kiluhabe/Radio/ROADMAP.md

# 🗺️ Roadmap

- PCB 化
- OLED大型化
- ディスプレイアニメーション
- テープライクな録音・再生（下記「録音・再生機能」参照）
- スピーカー内蔵＋ジャック挿入時の自動切替（下記参照）

## スピーカー内蔵＋ジャック自動切替

小型スピーカーを内蔵し、ジャックにプラグが挿入されたらジャック出力へ切り替える構成。

### 必要な追加部品

| 部品 | 型番・仕様 | 備考 |
|---|---|---|
| マイクロスピーカー | 8Ω、23×16×4.6mm（[秋月 g112495](https://akizukidenshi.com/catalog/g/g112495/)） | 定格入力がページに未記載。0.5〜1W程度と推定 |
| モノラルアンプ | PAM8302A（2.5W BTL） | スピーカーが1個なのでステレオのPAM8403より素直 |
| スイッチ付きステレオジャック | MJ-352W-C（[秋月 g117359](https://akizukidenshi.com/catalog/g/g117359/)） | **現行のMJ-355Wはスイッチ接点なしのため交換が必要** |
| 抵抗 | 10kΩ×2 | L/Rをモノラル合成する用 |

### 信号経路

```
M5807PA LOUT/ROUT
  → 音量ポット（10kΩ Aカーブ2連）
      ├→ MJ-352W-C（ライン出力、アクティブスピーカー用）
      └→ 抵抗でL+Rをモノラル合成 → PAM8302A → 内蔵8Ωスピーカー
                                        ↑
                          SHUTDOWNピン ← ジャックのスイッチ接点
```

ポットの後段から分岐するので、物理ボリュームが内蔵スピーカーにも効く。切替はジャックの接点でアンプのSHUTDOWNピンを叩く形にすれば**ファームウェア変更は不要**（純ハードウェアで完結）。

### 注意点

- **スピーカーの定格入力が不明**。PAM8302Aをデフォルトゲイン（24dB）で使うと過大入力で破損の可能性がある。ゲイン設定抵抗を絞るか、実測しながら調整すること
- 23×16mmの小型なので低音はほぼ出ない。**密閉されたエンクロージャを筐体側に作り込むのが最も効く対策**（裸のユニットは前後の音が打ち消し合って低域が消える）。録音機能でADC→DSP→DACの経路を通すなら、倍音合成型のバスエンハンスをエフェクトの一つとして入れる手もある
- ポット出力にアンプ入力を並列でぶら下げるので負荷が変わる。10kΩポットとPAM8302Aの入力インピーダンスなら問題ない範囲のはずだが、実装後に音量カーブを確認すること

## 録音・再生機能（テープライク、検討メモ）

対象は**「2h順次上書きバッファ」「エンコーダーでのプレイバックサーチ」「再生速度変更」「エフェクト」の4つ**。

### 設計の要：全部バッファ経由にする

現状はFM音声がRP2040-Zeroを一切通らずポットへ直行しているが、これを「常にADC→RP2040-Zero→DAC」に変え、録音バッファへ常時書き込み続ける構成にする。すると「ライブ再生」は単に「読み出し位置＝書き込み位置」という特殊ケースになり、サーチ・可変速・エフェクトが全て同じ経路で処理できる。アナログの分岐・切替回路が不要になる。

### 容量と帯域の見積もり

| 形式 | 2h容量 | 帯域 |
|---|---|---|
| 32kHz/16bit/ステレオ | 約920MB | 128 kB/s |
| 32kHz/16bit/モノラル | 約460MB | 64 kB/s |
| 16kHz/16bit/モノラル | 約230MB | 32 kB/s |

FM放送の音声帯域は15kHzなので32kHzサンプリングで十分。microSDなら容量は問題にならない。常時録音しながらスクラブで別位置を読む場合は読み書き同時＝最大256kB/s程度だが、SPI接続SDでも1MB/s以上出るため余裕がある（ただし書き込み領域と読み出し領域を往復するシークが増えるので、64KB単位でまとめ書きするバッファ設計が必要）。

CPUは32kHzなら1サンプルあたり約4000サイクル使える計算で、線形補間による可変速＋簡単なエフェクト（サチュレーション、ビットクラッシュ、ディレイ、簡易リバーブ）は十分入る。

### 可変速の方式

テープと同じくピッチも一緒に変わる方式なら、読み出しレートを変えて補間するだけで実装できる（安価）。ピッチを保ったままのタイムストレッチは桁違いに重いので、テープライクな挙動を狙うなら前者一択。逆再生もSDはランダムシーク可能なのでブロックを逆順に読むだけ。

### 追加が必要なハードウェア

- microSDカードスロット（SPI、4ピン）
- **DAC：PCM5102A DIP化キット**（[秋月 g111836](https://akizukidenshi.com/catalog/g/g111836/)、¥700）。RP2040にDACは内蔵されていないため必須。内蔵PLLを持つのでMCLK不要、BCLK/LRCLK/DINの3本で動く
- **ADC：以下のどちらか**
  - RP2040内蔵ADCを使う（追加チップ不要、ただしアンチエイリアス用LPFを自前で用意）
  - **PCM1808PWR DIP化キット**（秋月 AE-PCM1808PWR、¥250）を追加。**推奨**

GPIOは合計13本程度。現行のRP2040-Zero（エッジ20本）なら収まる。XIAO RP2040（11本）では不足。

### ADCの選択について

内蔵ADCと外部ADCの差は、当初考えていたほどSNRの問題ではない。無相関なノイズは電力で加算されるため、FM放送自体のSNR（良好時50〜60dB）とRP2040内蔵ADCの実効SNR（12bit公称／実効9bit程度＝約56dB）が同等でも、劣化は**+3dB程度**に留まる。「FMの出音からノイズを除去したいわけではない」「ラジオらしい飽和した質感が欲しい」という方向性なら、内蔵ADCでも十分許容範囲。

ただし性質の違いはある。FMのノイズは滑らかなヒスだが、RP2040内蔵ADCはDNL（微分非直線性）の既知の問題により**歪みとして出る**。歪みは信号と相関するため静かな部分でザラつきとして耳につきやすい。

**PCM1808の実質的な価値はSNRではなく「アナログフィルタの設計が不要になること」**にある：

- RP2040内蔵ADCには**アンチエイリアスフィルタが一切ない**。FMステレオの19kHzパイロット信号の残留成分が入ると折り返しノイズになる（32kHzサンプリングだと \|32−19\| ＝ **13kHzに折り返す**、可聴域のど真ん中）
- PCM1808は64倍オーバーサンプリング＋デジタルデシメーションフィルタ内蔵で、この対策が自動で済む

¥250でLPF設計の手間が消えるなら、PCM1808を入れるほうが結果的に安上がり。

### サンプリング周波数は44.1k/48kHzを推奨

以前「FMの音声帯域は15kHzだから32kHzで十分」としていたが、19kHzパイロットの折り返しを考慮すると不十分。44.1kHzならパイロットはナイキスト周波数以下なので折り返さない。容量は44.1kHz/16bit/ステレオで2時間約1.27GB、SDカードなら問題ない。

### クロック設計の注意点

- PCM5102Aは内蔵PLLを持つのでMCLK不要
- **PCM1808はシステムクロック（SCKI、通常256fs）の供給が必要**。44.1kHzなら11.2896MHz。RP2040のクロック出力（GPOUT）やPIOで生成できるが、設計時に考慮が要る

### 調査済み：チューナーからのI2S直結は不可

RDA5807Pチップ自体はI2S出力に対応している（GPIO1→WS、GPIO2→SD、GPIO3→SCK、レジスタ04H bit6のI2S_ENABLEで有効化、16bit最大48kHz）。これが使えればADCが完全に不要になり、アナログ入力の配線・DCバイアス・アンチエイリアスフィルタが全て省ける最良の構成だった。

**しかしM5807PA（および秋月等で流通する同規格のRRD-102 V2.0）は、チップのGPIO1/2/3をモジュール基板上でどこにも配線していない。** RRD-102 V2.0のリバースエンジニアリング結果では10ピンの構成は `SDIO, SCLK, N/C, N/C, VCC, GND, LOUT, ROUT, N/C, ANT` で、N/Cは文字通り未接続と明記されている。

I2Sを使うにはSOP16のIC（1番・15番・16番ピン）へ直接リード線をはんだ付けするしかなく、11.2×11.2mmのモジュール上での作業としては現実的でない。**アナログ入力で受ける方針で確定。**

### 既存コードへの影響（要注意）

1. `Cargo.toml`が現在「core1は絶対に起動しない」前提になっている（`portable-atomic`の`unsafe-assume-single-core`、および`storage.rs`のフラッシュアクセス）。SDストリーミングをcore1に分離するなら、この前提の見直しが必要
2. `rp2040-flash`による設定保存は書き込み中XIPを止めるため音声が途切れる。オーディオ処理と同居させるなら保存タイミングの制御か、設定もSDへ逃がす検討が必要

### 進め方

1. SD＋コーデックで「録って頭から再生」を通す
2. スクラブ・逆再生・可変速
3. エフェクト

1が通れば残りは全て同じ再生パス上の話になる。
