kiluhabe/Radio/hardware/models/Button.stl

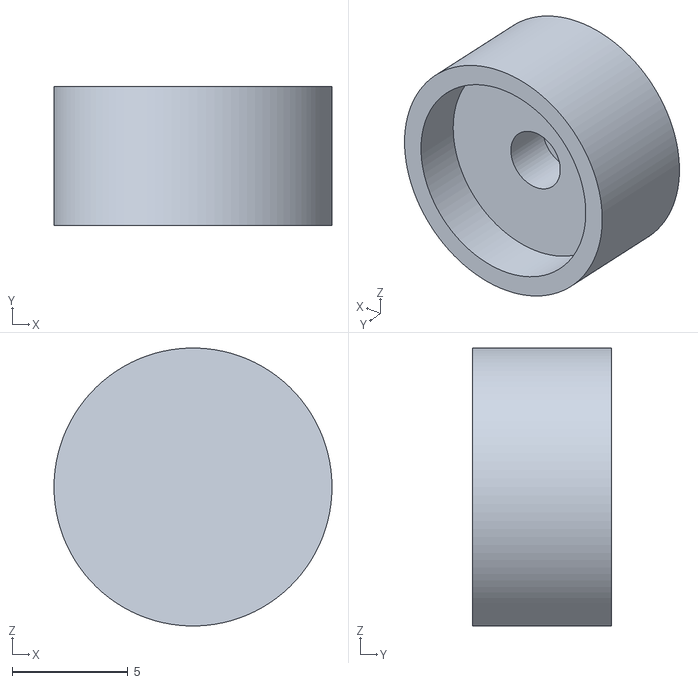
[picture p1: CAD file, 2026-10-16]
hardware/models/Button.stl
12.0 x 6.00 x 12.0
