kiluhabe/Radio/hardware/models/CaseTop.stl

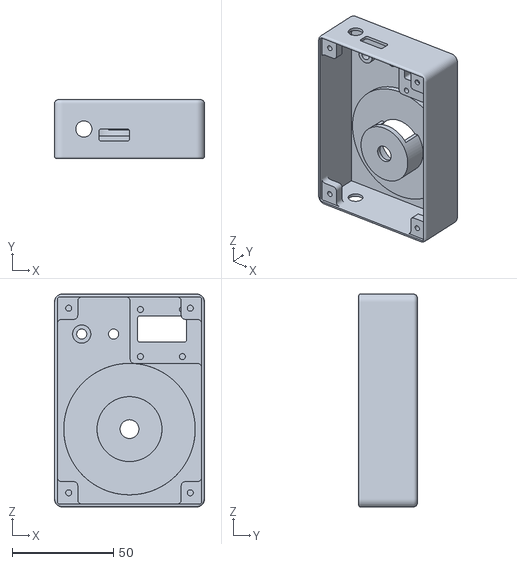
[picture p2: CAD file, 2026-10-16]
hardware/models/CaseTop.stl
74.0 x 29.0 x 105.0
