kiluhabe/Radio/hardware/models/Disc.stl

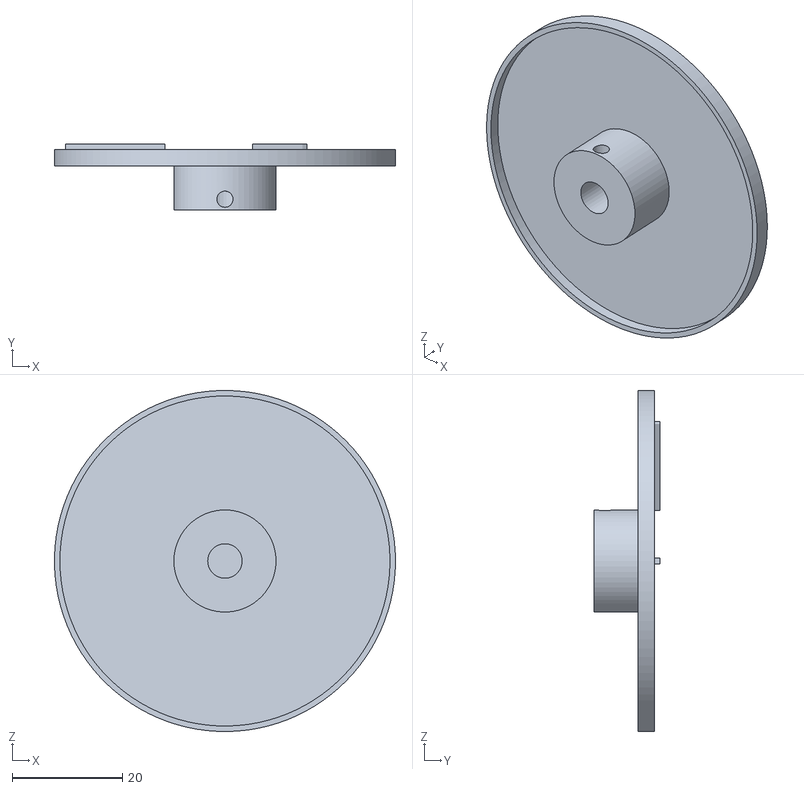
[picture p3: CAD file, 2026-10-16]
hardware/models/Disc.stl
61.8 x 12.0 x 61.8
