kiluhabe/Radio/hardware/models/CaseBottom.stl

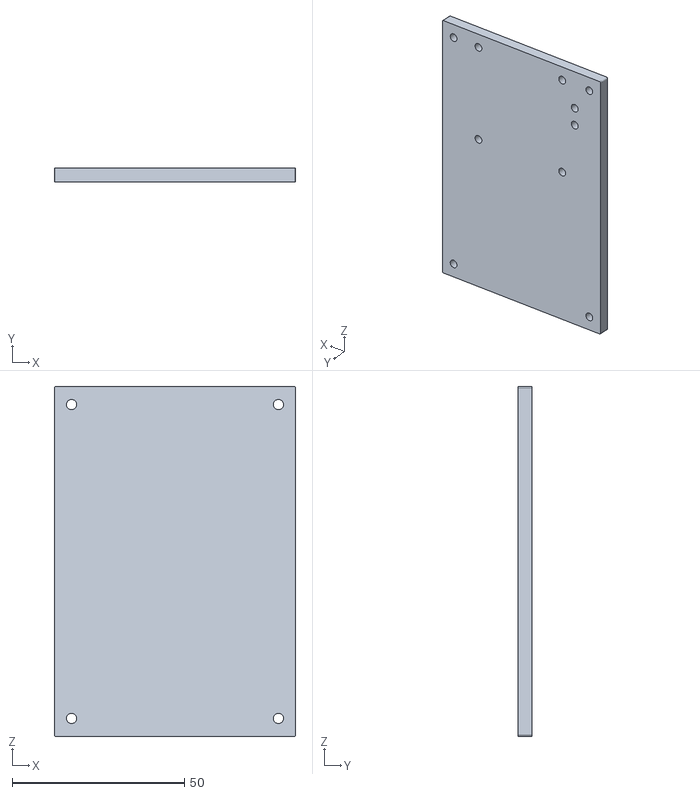
[picture p4: CAD file, 2026-10-16]
hardware/models/CaseBottom.stl
70.0 x 4.00 x 101.5
