kiluhabe/Radio/hardware/models/VolumeNob.stl

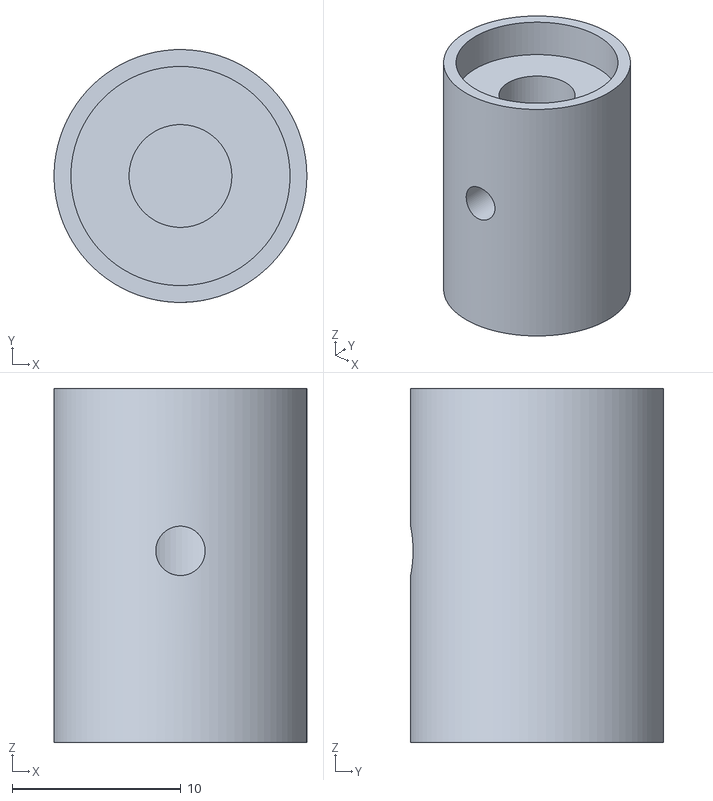
[picture p5: CAD file, 2026-10-16]
hardware/models/VolumeNob.stl
15.0 x 15.0 x 21.0
