kiluhabe/Radio/radio-core/src/lib.rs

#![cfg_attr(not(test), no_std)]

pub mod types;
pub use types::*;

pub mod quadrature;
pub use quadrature::QuadratureDecoder;

pub mod button;
pub use button::ButtonDebouncer;

pub mod ports;
pub use ports::{ButtonInput, Clock, Display, Encoder, Screen, Storage, Tuner};

pub mod state;
pub use state::RadioState;
