kiluhabe/Radio/(commit log)

2026-05-09 prototype build
2026-07-22 Migrate to Raspberry Pi Pico build, drop amp for active-speaker design
    Replace the Arduino Pro Mini prototype with a Pico + RP2040 firmware
    (TUNE/FAV modes, EEPROM via flash emulation). Remove the EEHD-4RWA amp
    after finding its BTL outputs can't be commoned onto a standard TRS
    jack; volume is now a passive pot ahead of the jack instead. DIYLC
    layout, soldering, and JST-cable docs are all synced to the verified
    radio-rp.diy board file. Drop the stale Wokwi diagram and legacy
    Pro Mini docs/parts/wiring files.
    Claude-Session: https://claude.ai/code/session_01TfS5EzMQ7br6ExF8NpgAJv
2026-07-23 feat: scaffold Rust workspace, verify RP2040 build/flash with LED blink
    Empty radio-core lib crate plus firmware/rp2040 blink binary to prove the
    thumbv6m-none-eabi toolchain and linker setup work end to end before any
    radio logic gets ported.
    - radio-core: no_std lib scaffold, builds on host (cargo build -p radio-core)
    - firmware/rp2040: rp-pico-based GP25 blink, builds --release and converts
    to a valid UF2 via elf2uf2-rs
    - firmware/rp2040 gets its own [workspace] table so it stays out of the
    root workspace (its embedded-target .cargo/config.toml would otherwise
    break radio-core's host build)
    - build.rs no longer duplicates the --nmagic/-Tlink.x flags already set in
    .cargo/config.t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
    [build.rs, lib.rs, main.rs]
2026-07-23 fix: revert defmt/defmt-rtt/panic-probe to brief-pinned versions (unneeded bump)
    The 1.0-line bump was justified by a claimed defmt version conflict with
    rp2040-hal's transitive defmt dependency. That dependency is optional and
    gated by a feature rp-pico never enables (features: []), so it's never
    activated in this build — the conflict doesn't exist. Reverting to the
    brief's exact pins (defmt 0.3, defmt-rtt 0.4, panic-probe 0.3) builds
    cleanly.
2026-07-23 feat(radio-core): add Mode, Settings, ButtonEvent types
2026-07-23 feat(radio-core): add QuadratureDecoder for rotary encoder
2026-07-23 feat(radio-core): add ButtonDebouncer (short/long/double press)
    [button.rs, lib.rs]
2026-07-23 feat(radio-core): define Tuner/Display/Encoder/ButtonInput/Storage/Clock ports
    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
2026-07-23 feat(firmware): add Rda5807Tuner adapter
    rda5807m 0.1.0 has no public setter for REG03's BAND/SPACE bits (only a
    get_band_and_spacing() getter) and its write_register/update_register
    are private, non-pub(crate) fns with no field access either, so there's
    no in-crate path to configure Japan's wide FM band. Worked around it by
    destroy()-ing the driver to reclaim the raw I2C bus, writing REG03
    directly with the crate's own register_address constants
    (BAND_76_108_MHZ | SPACE_100_KHZ), then rebuilding the driver -
    confirmed via the crate's actual source that this must run after
    start() (which clobbers REG03) and that set_frequency() preserves
    these bits afterward.
    Also fixes a unit bug in the or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
    [tuner.rs]
2026-07-24 feat(firmware): add Ssd1306Display adapter
    Transcribes the brief's Ssd1306Display verbatim: ssd1306 0.9.0 and
    embedded-graphics 0.8.2 (the versions the "0.9"/"0.8" Cargo.toml
    constraints actually resolve to) match the brief's API exactly, so no
    crate-drift workaround was needed here (unlike Task 9's rda5807m). Also
    adds heapless explicitly since render() builds its two text lines with
    heapless::String, which requires a direct Cargo.toml entry to be usable
    even though it's already pulled in transitively.
    Verified by temporarily wiring a verify_ssd1306_display() fn into
    main.rs that constructs the adapter against a real rp2040-hal I2C1
    peripheral (proving embedded_hal::i2c::I2c is actually sa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
    [display.rs]
2026-07-24 feat(firmware): add FlashStorage adapter (MVP, magic-number validated)
    rp2040-flash's real API (checked against source for 0.5.2/0.6.0) has no
    flash_read function -- flash is memory-mapped (XIP) during normal
    execution, so load() reads directly through that address range instead.
    Uses flash_range_erase_and_program (a single erase+program call) rather
    than separate erase/program calls, matching the crate's own example for
    this exact rewrite-a-sector pattern.
    Pinned rp2040-flash to 0.5 rather than the newer 0.6: 0.6 pulls in
    rp2040-hal 0.11 while rp-pico 0.9 pulls in rp2040-hal 0.10.2, and having
    both versions in the graph makes fat LTO fail to link with duplicate
    compiler-builtins symbols. 0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
    [storage.rs]
2026-07-24 fix(firmware): use read_unaligned for StoredSettings deserialization
    core::ptr::read requires the source pointer to be properly aligned for
    the target type, but `buf` is a [u8; N] array which only guarantees
    alignment 1, not the alignment 4 that StoredSettings (starts with a
    u32) needs. This was undefined behavior, and on RP2040's Cortex-M0+
    (ARMv6-M) cores a misaligned typed word load can genuinely fault at
    runtime rather than merely violate an abstract soundness rule.
    read_unaligned has no alignment requirement and is the correct API for
    reading a typed value out of a possibly-misaligned byte buffer.
    [storage.rs]
2026-07-24 feat(firmware): wire composition root (build-verified; hardware bring-up pending)
    Completes main.rs as the RP2040 composition root: constructs all six
    adapters from Tasks 7-11, shares I2C0 between the tuner and display via
    a RefCell (embedded-hal-bus's RefCellDevice for the display's
    embedded-hal 1.0 needs, a small local shim for the tuner's legacy
    embedded-hal 0.2 needs, since embedded-hal-bus has no equivalent for
    those traits), and implements the full button-event/power/mode/favorites
    control flow mirroring radio-rp.ino's loop().
    embedded-hal-bus pulls in portable-atomic's CAS fallback via its (unused
    here) atomic module, which needs unsafe-assume-single-core on thumbv6m;
    added that depe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
2026-07-24 fix(firmware): retune tuner when entering FAV mode via short-press (display/audio parity with Arduino enterFavMode())
    cycle_mode() can silently change radio.settings.freq when entering FAV
    mode (jumping to the first saved favorite), but the ButtonEvent::Short
    arm never pushed that frequency to the tuner. The OLED would show the
    new frequency while the tuner hardware kept playing the old station.
    Mirrors the Arduino reference's enterFavMode, which calls
    rx.setFrequency(currentFreq) after the same state change.
    [main.rs]
2026-07-24 Fix final-review findings: storage load validation, autosave power gate
    - storage.rs load(): reject the stored blob (return None, fall back to
    Settings::default()) when the stored frequency is out of
    [FREQ_MIN, FREQ_MAX], and when any stored favorite is out of range --
    matching radio-rp.ino's loadSettings(), which discards the whole blob
    on the first bad favorite rather than skipping just that entry.
    - main.rs: gate the bottom-of-loop autosave check on power_on, mirroring
    the Arduino loop()'s "if (!powerOn) return;" guard structurally, not
    just in emergent behavior (all current dirtying paths were already
    power-gated, so this closes a latent trap rather than fixing a live bug).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
    [main.rs, quadrature.rs, state.rs, storage.rs]
2026-07-25 fix(firmware): replace rda5807m crate with a self-contained RDA5807 register driver
    On real hardware, tuning never worked: the OLED and RSSI meter updated
    correctly, but the demodulated station never changed. Root cause: the
    rda5807m crate's set_frequency()/mute()/set_volume() are read-modify-write
    -- each reads its target config register (REG03/REG02/REG05) back over
    I2C before merging in new bits. On this hardware that readback does not
    reflect what was actually written, silently corrupting every field outside
    the one being changed (REG03's CHAN bits above all, hence stuck tuning
    despite the chip visibly re-locking on every call).
    Confirmed as a firmware regression, not a hardware fault: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
    [main.rs, tuner.rs]
2026-10-16 feat: v1 — RP2040-Zero bring-up on the radio-rpv2 wiring
    - Pin map matches hardware/diylc/radio-rpv2.diy: I2C1 SDA/SCL=GP26/GP27,
    encoder A/B=GP12/GP13, action button=GP11, pot power switch=GP10,
    WS2812B status LED=GP9 (PIO0)
    - Mechanical EC10E encoder: 4 transitions per detent (1 click = 0.1MHz),
    direction fixed; OLED unrotated
    - Frequency-only screen with a thin vector digit font, redrawn only on
    state changes
    - Add case/knob/disc STLs and ROADMAP.md; refresh README and parts list
    - Remove the Arduino sketches, the superseded radio-rp.diy, and docs that
    no longer match the hardware
    Claude-Session: https://claude.ai/code/s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
    [Button.stl, CaseBottom.stl, CaseTop.stl, Disc.stl, VolumeNob.stl]
2026-10-18 refactor(firmware): remove unused RSSI path and split power sequences
2026-10-18 feat(display): render all OLED text with Radio Canada bitmaps
    Replace the hand-drawn vector numerals and FONT_6X10 label with 1bpp
    glyphs rasterized from Radio Canada (OFL-1.1) by tools/gen_font.py.
    [bitmap_font.rs, display.rs]
2026-10-18 docs: treat the .diy as the wiring source and slim the parts list
2026-10-24 feat(display): invert the OLED in FAV mode
    [display.rs]
